jpwolfe31/solari-split-flaps/README.md

# Solari-Split-Flaps
Information, designs and code to operate a Solari split-flap display using the Blynk app.

The split-flaps were acquired on eBay in April of 2023.  We were told they were installed at an airport in the 1960s and removed about 20 years ago.  This represents a small portion of the original display.  The electronics that control the display are new and contained in the black box next to the time display.  To see the display in operation go to https://www.youtube.com/watch?v=Qq5hUmP4TP0.



# more
See folders above for code, schematics, build information, printed circuit boards and historic technical documents.  Feel free to email me at jpwolfe31@yahoo.com if you have any questions.
