jpwolfe31/solari-split-flaps/Schematics/Hall Sensor Board Schematic 12-5-23.pdf

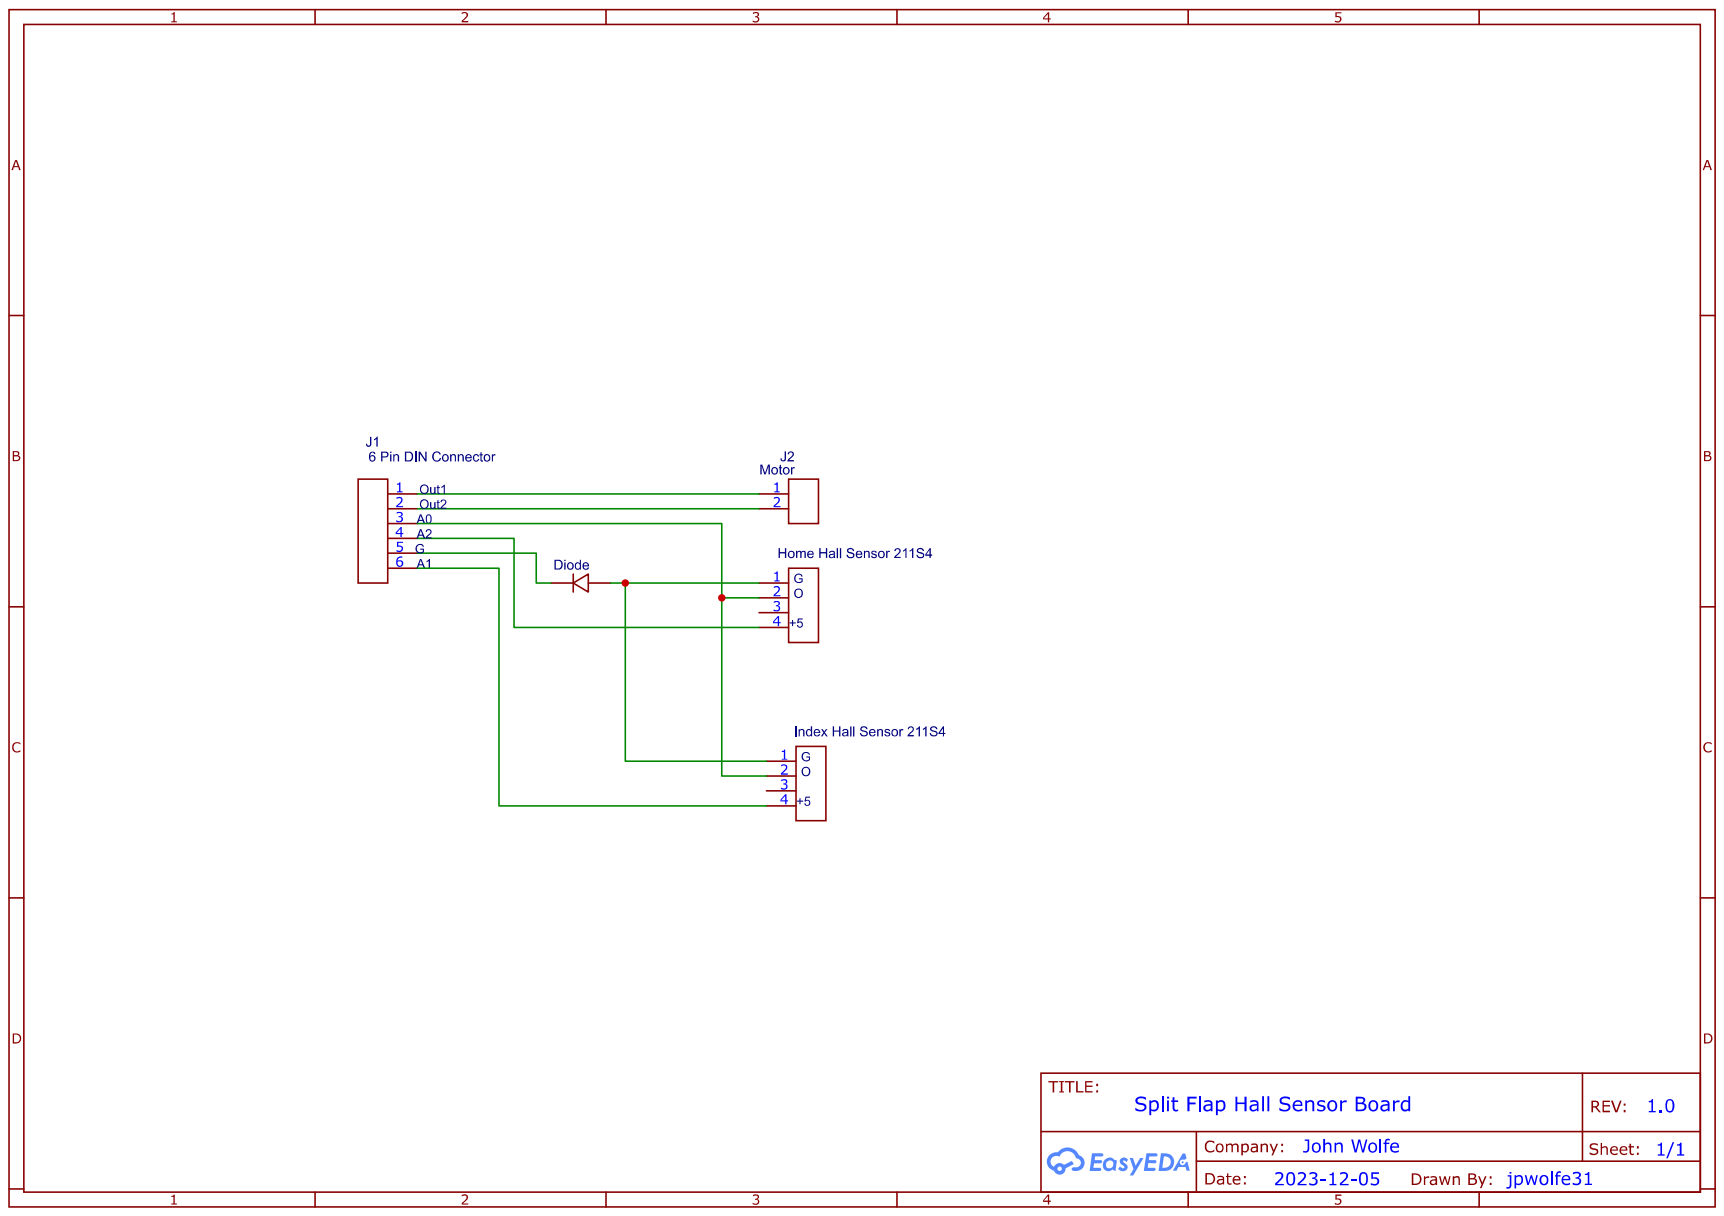
[picture p34: page 1]
