jpwolfe31/solari-split-flaps/Schematics/Controller Board Schematic 8-8-23.pdf

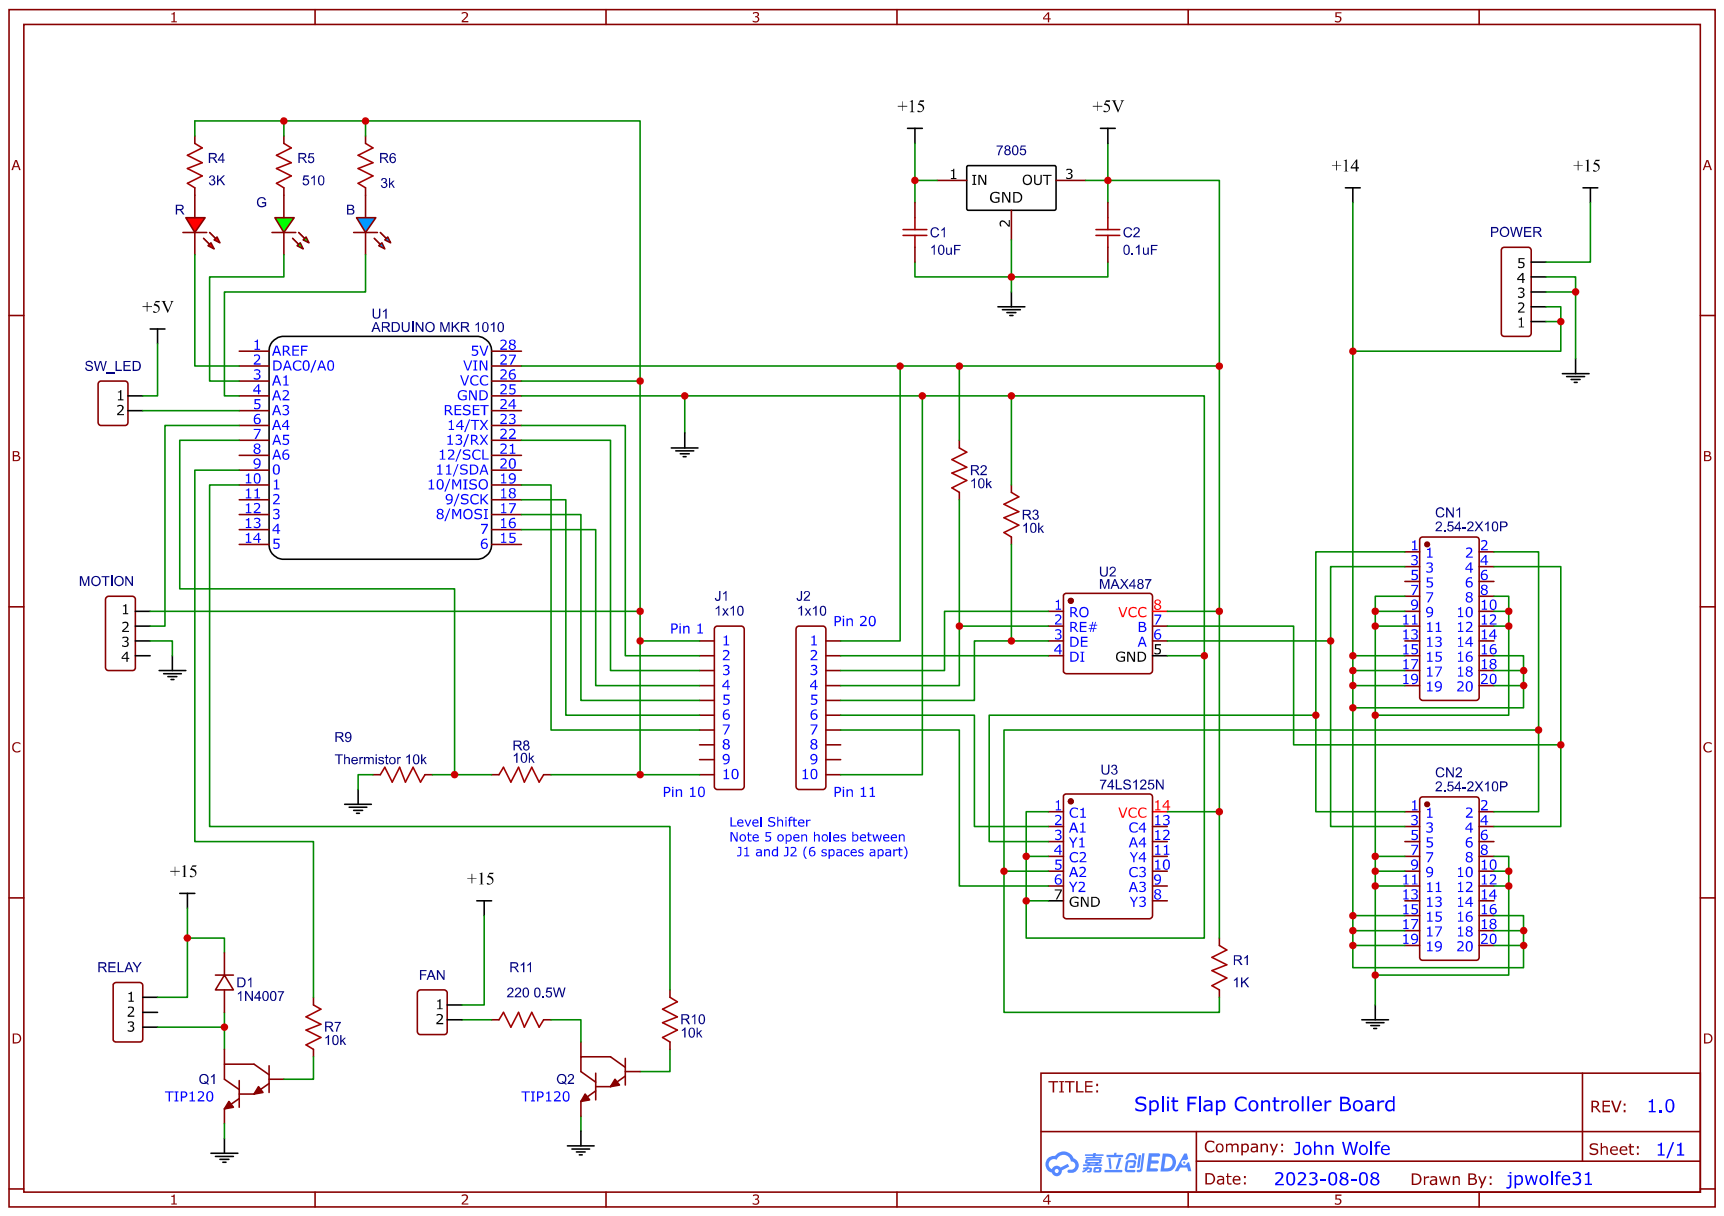
[picture p35: page 1]
