jpwolfe31/solari-split-flaps/Schematics/Controller Box Schematic 11-26-23.pdf

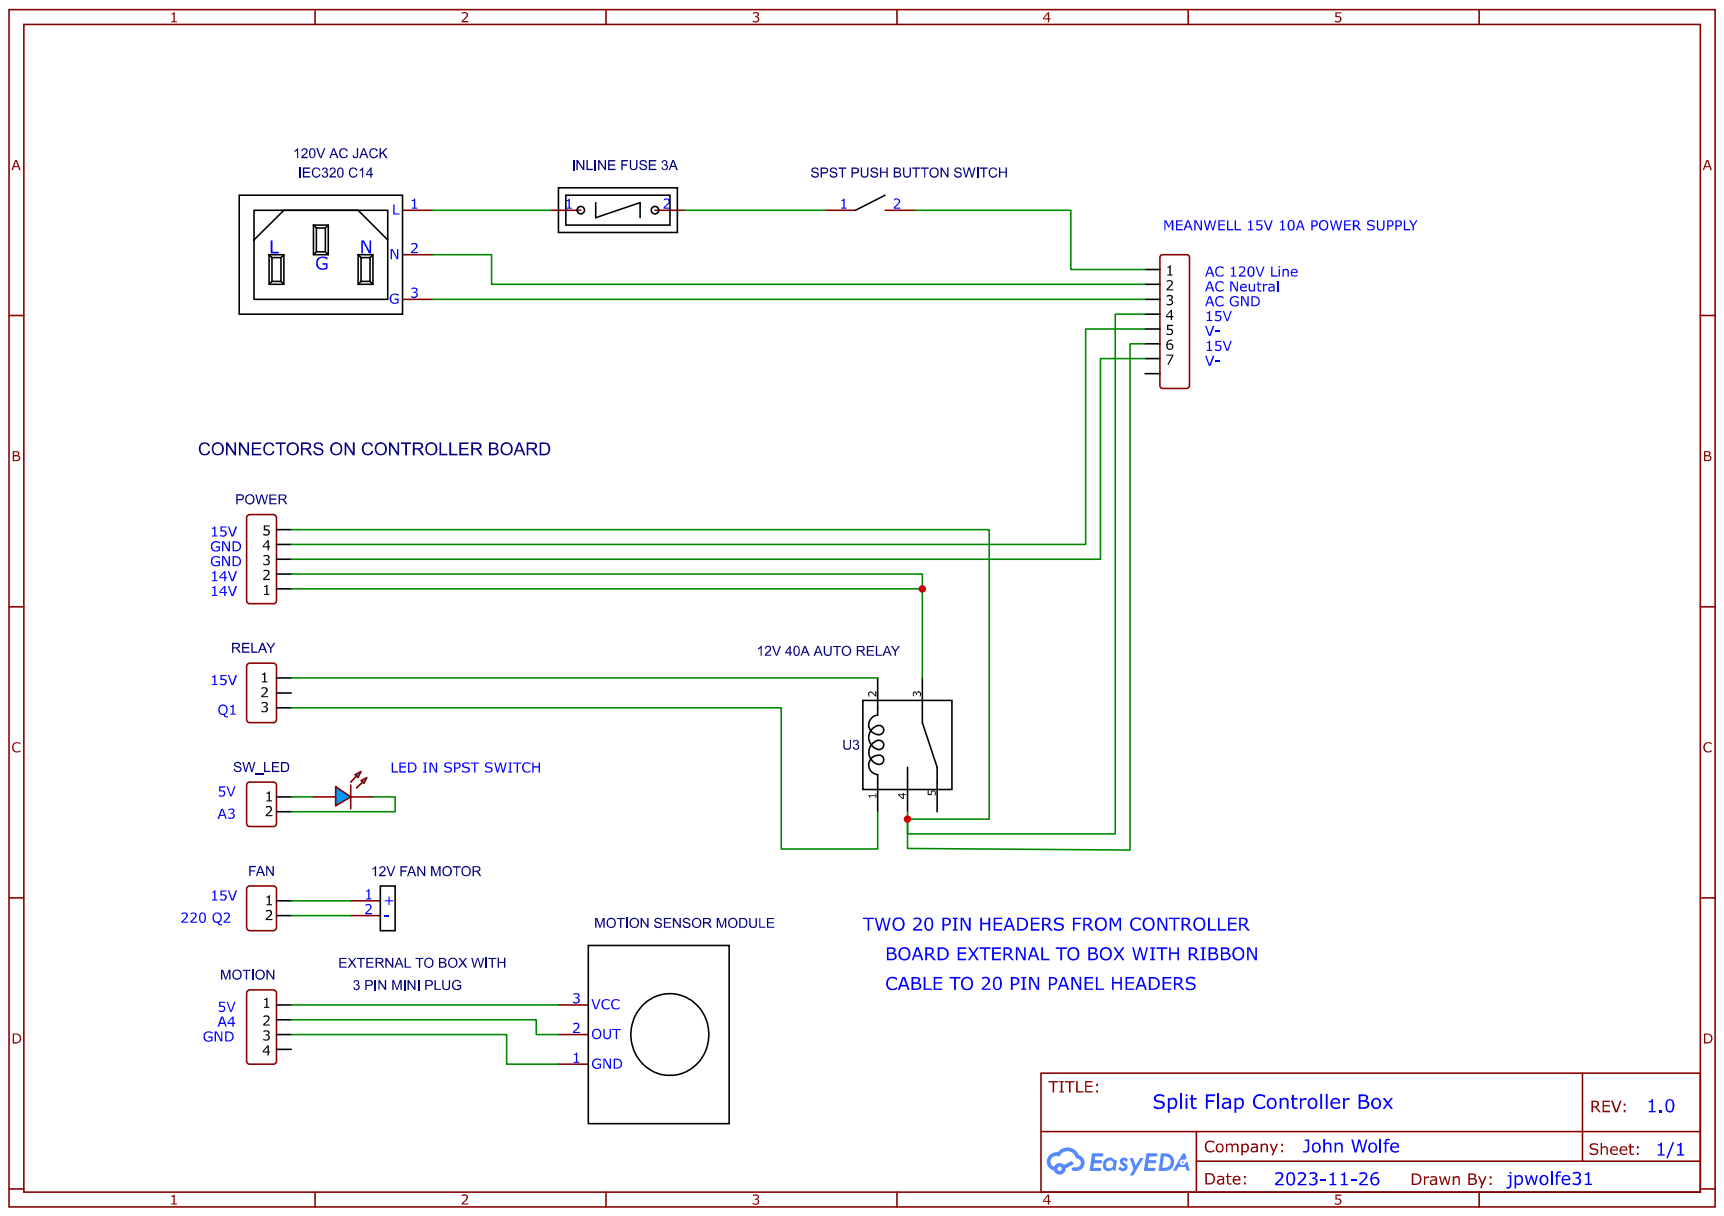
[picture p36: page 1]
