jpwolfe31/solari-split-flaps/Schematics/Remote Board Schematic 4-25-23.pdf

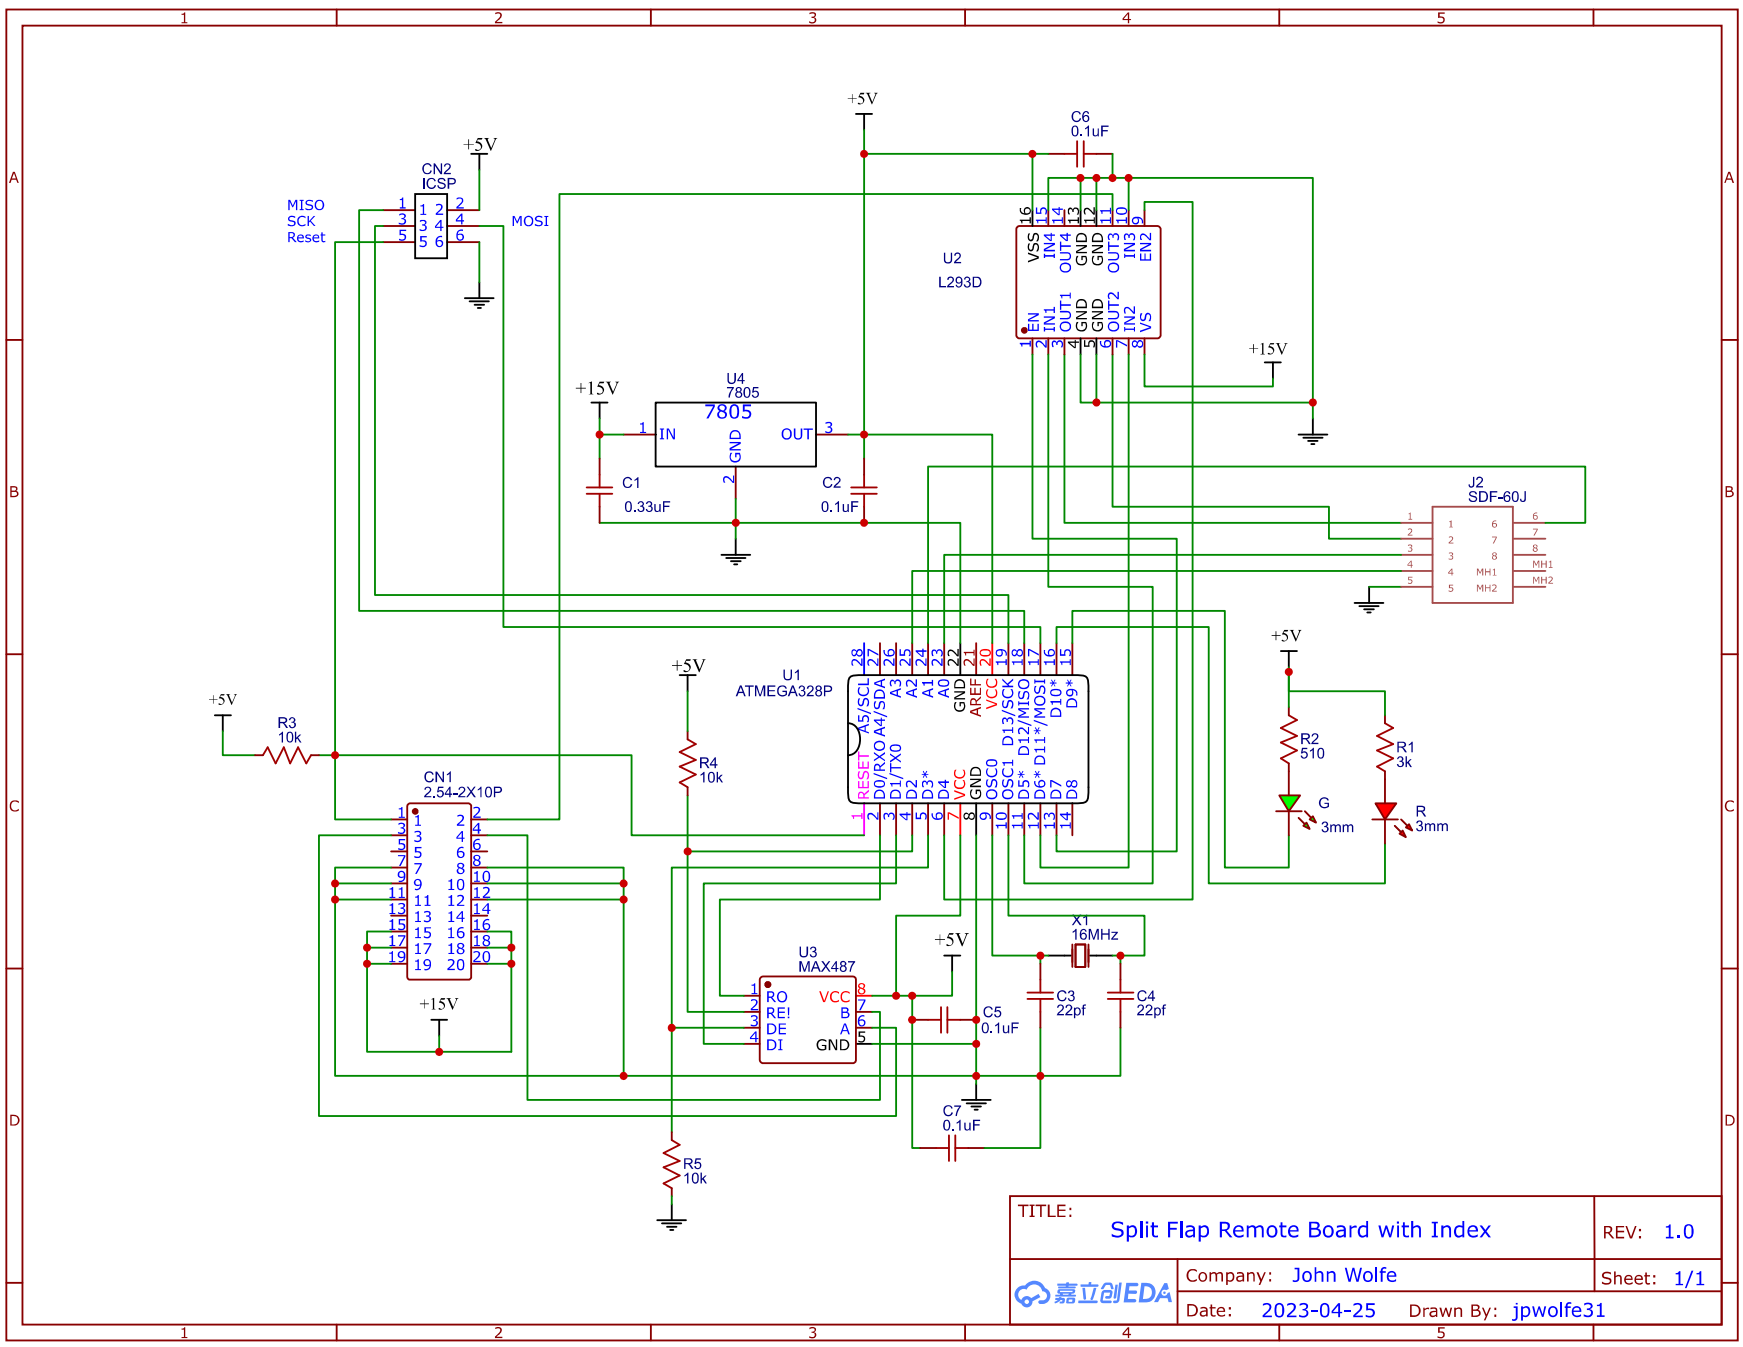
[picture p37: page 1]
