jpwolfe31/solari-split-flaps/(list of files, drawings)

Other design files:
EasyEDA files 12-1-23/EasyEDA PCB_Skip Flap Remote Board with Index 12-1-23.json
EasyEDA files 12-1-23/EasyEDA PCB_Split Flap Controller Board 12-1-23.json
EasyEDA files 12-1-23/EasyEDA Schematic_Split Flap Controller Board 12-1-23.json
EasyEDA files 12-1-23/EasyEDA Schematic_Split Flap Remote Board with Index 12-1-23.json
